smorales2405/Tesis_Mecanismo/LaTeX/Tesis_2025_1/images/1B.png

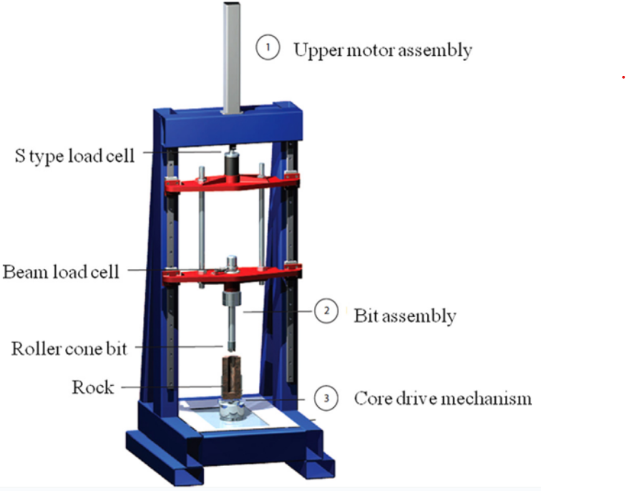
LaTeX/Tesis_2025_1/images/1B.png
