smorales2405/Tesis_Mecanismo/LaTeX/Tesis_2025_1/images/Esquematico_Tesis_bb2.png

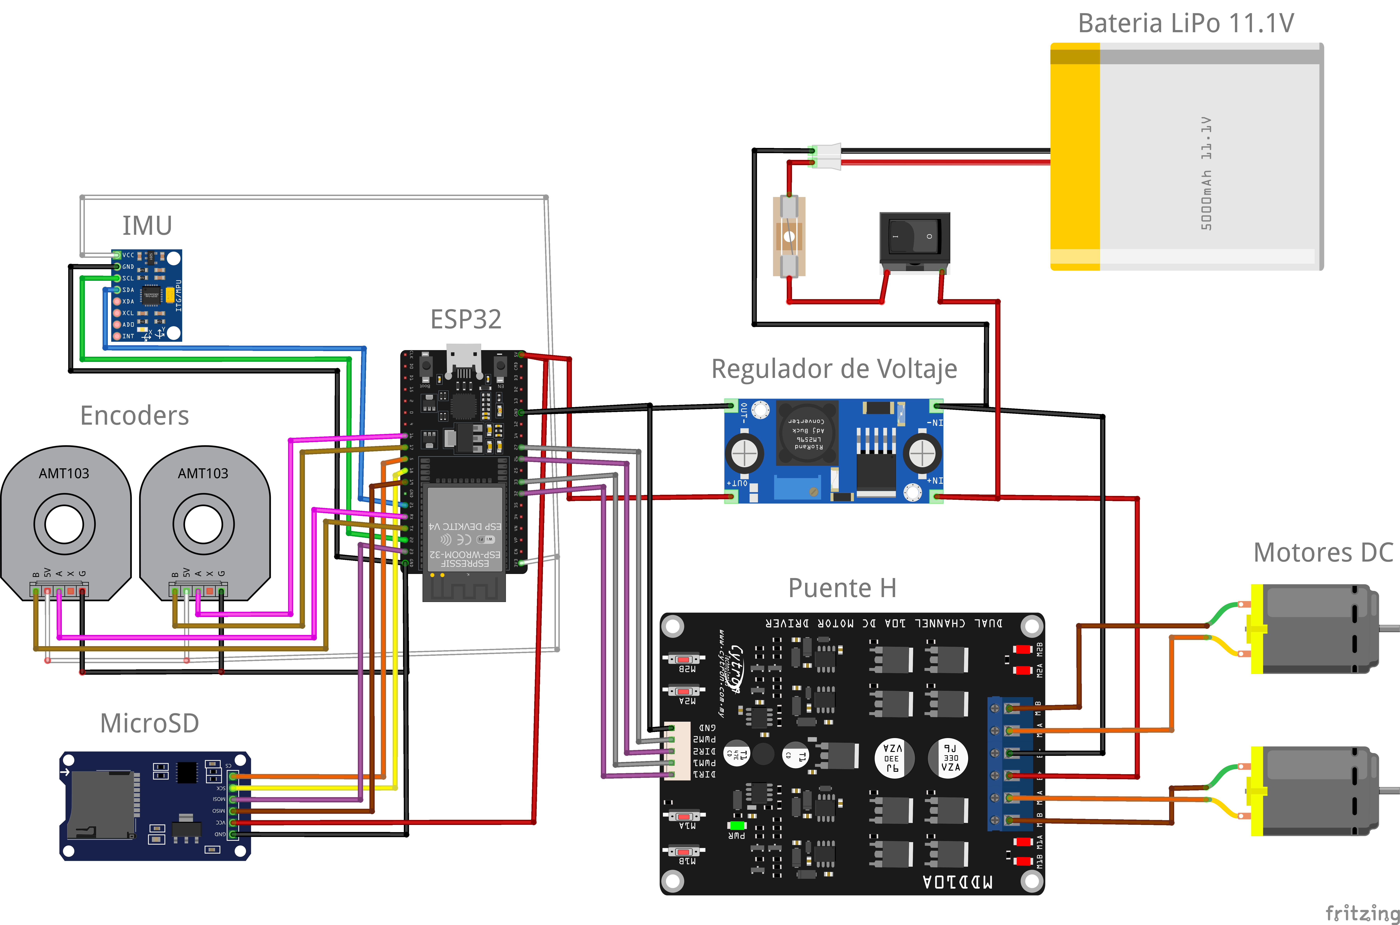
LaTeX/Tesis_2025_1/images/Esquematico_Tesis_bb2.png
