smorales2405/Tesis_Mecanismo/LaTeX/Tesis_2025_1/images/mecanismo_sevim.png

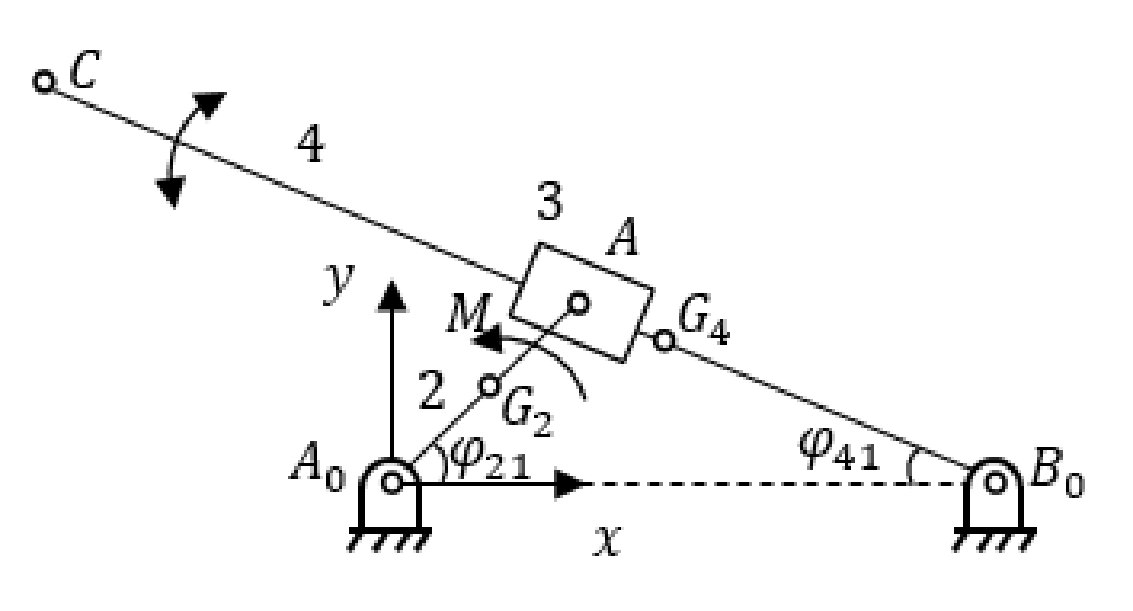
LaTeX/Tesis_2025_1/images/mecanismo_sevim.png
