smorales2405/Tesis_Mecanismo/LaTeX/Tesis_2025_1/images/simu.jpg

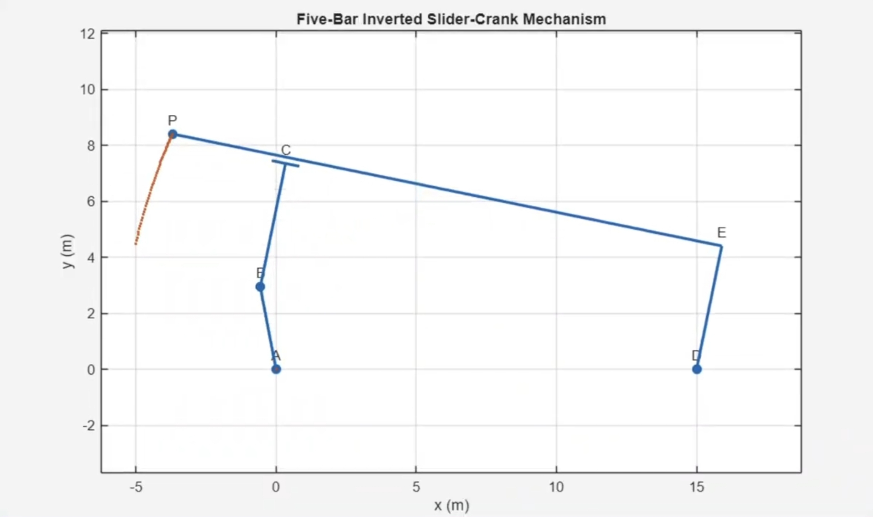
LaTeX/Tesis_2025_1/images/simu.jpg
