smorales2405/Tesis_Mecanismo/CAD/Piezas Variadas/Chumaceras/KFL08 - Mancal Flange oval Ø8.stp

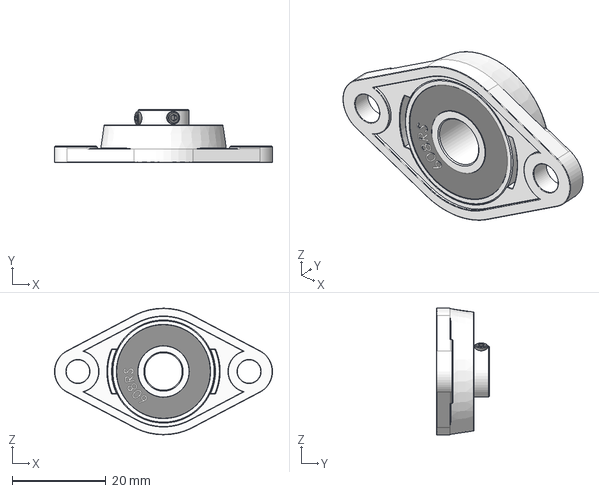
[picture p41: CAD file, 2025-10-18]
CAD/Piezas Variadas/Chumaceras/KFL08 - Mancal Flange oval Ø8.stp
46.5 x 11.4 x 27.0 mm
