smorales2405/Tesis_Mecanismo/CAD/Piezas Variadas/Motores/motor_bracket_base3.stl

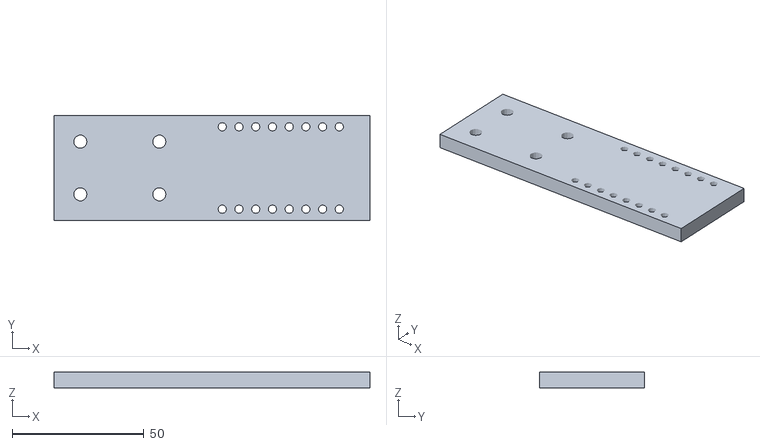
[picture p42: CAD file, 2025-11-20]
CAD/Piezas Variadas/Motores/motor_bracket_base3.stl
120.0 x 40.0 x 6.00
