smorales2405/Tesis_Mecanismo/CAD/Piezas Variadas/V_slots/2020 3-Bracket.stl

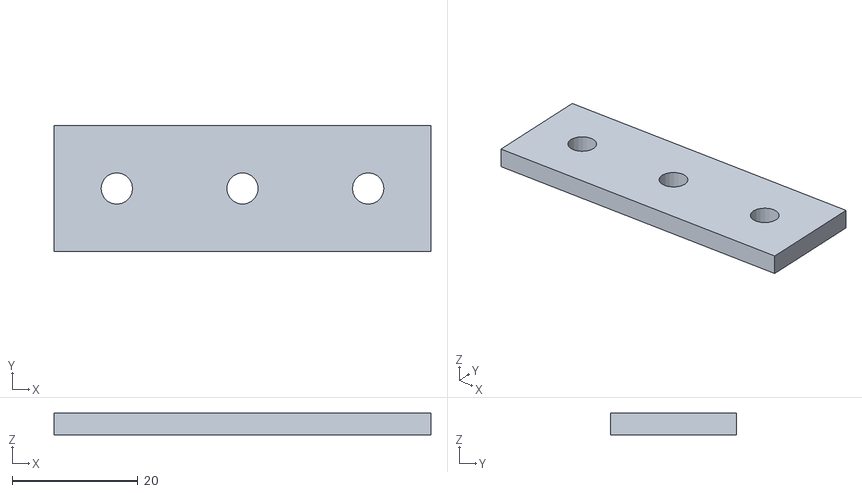
[picture p43: CAD file, 2025-11-19]
CAD/Piezas Variadas/V_slots/2020 3-Bracket.stl
60.0 x 20.0 x 3.50
