smorales2405/Tesis_Mecanismo/CAD/Piezas Variadas/V_slots/2020 gR Bracket.stl

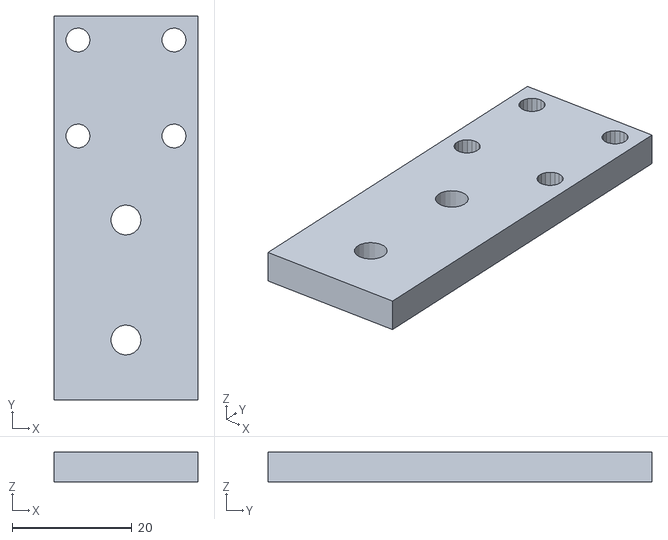
[picture p44: CAD file, 2025-11-17]
CAD/Piezas Variadas/V_slots/2020 gR Bracket.stl
24.0 x 64.0 x 5.00
