smorales2405/Tesis_Mecanismo/(list of files, cad)

Other CAD files:
CAD/Piezas Variadas/Motores/motor_bracket_base2.stl
CAD/Piezas Variadas/Motores/motor_bracket_base.stl
CAD/Base/Mecanismo_base_2.iam
CAD/Base/Mecanismo_base_al.ipt
CAD/Base/Mesa/Bord.iam
CAD/Base/Mesa/ben.ipt
CAD/Base/Mesa/ram.ipt
CAD/Base/Mesa/skiva.ipt
CAD/Linear Actuator/Linear Mechanism/1109-0024-0288.ipt
CAD/Linear Actuator/Linear Mechanism/1120-0011-0288.ipt
CAD/Linear Actuator/Linear Mechanism/1309-0016-4008.iam
CAD/Linear Actuator/Linear Mechanism/1310-0016-5008.iam
CAD/Linear Actuator/Linear Mechanism/1606-0043-0000.ipt
CAD/Linear Actuator/Linear Mechanism/1606-0043-0008.iam
CAD/Linear Actuator/Linear Mechanism/1611-0514-0008.iam
CAD/Linear Actuator/Linear Mechanism/1613-0516-0008 (1).iam
CAD/Linear Actuator/Linear Mechanism/1613-0516-0008 ball.ipt
CAD/Linear Actuator/Linear Mechanism/1613-0516-0008 carriage 15.5mm OD (1).iam
CAD/Linear Actuator/Linear Mechanism/1613-0516-0008 carriage 15.5mm OD.iam
CAD/Linear Actuator/Linear Mechanism/1613-0516-0008 washer (8.0mm ID x 15.5mm OD).ipt
CAD/Linear Actuator/Linear Mechanism/1613-0516-0008 washer (8.3mm ID x 15.5mm OD).ipt
CAD/Linear Actuator/Linear Mechanism/1613-0516-0008.iam
CAD/Linear Actuator/Linear Mechanism/2302-0014-0060.ipt
CAD/Linear Actuator/Linear Mechanism/2800-0004-0007.ipt
CAD/Linear Actuator/Linear Mechanism/2800-0004-0011.ipt
CAD/Linear Actuator/Linear Mechanism/2800-0004-0012.ipt
CAD/Linear Actuator/Linear Mechanism/2800-0004-0014.ipt
CAD/Linear Actuator/Linear Mechanism/3501-0804-0300.ipt
CAD/Linear Actuator/Linear Mechanism/3504-0804-2109.iam
CAD/Linear Actuator/Linear Mechanism/3505-0804-3216.ipt
CAD/Linear Actuator/Linear Mechanism/3704-0043-0002 w.Hardware (1).iam
CAD/Linear Actuator/Linear Mechanism/3704-0043-0002 w.Hardware.iam
CAD/Linear Actuator/Linear Mechanism/HARDWARE.iam
CAD/Linear Actuator/Linear Mechanism/IR.ipt
CAD/Linear Actuator/Linear Mechanism/Lead Screws/3501-0804-0150.ipt
CAD/Linear Actuator/Linear Mechanism/Lead Screws/3501-0804-0250.ipt
CAD/Linear Actuator/Linear Mechanism/OR.ipt
CAD/Linear Actuator/Linear Mechanism/OldVersions/HARDWARE.0001.iam
CAD/Linear Actuator/Linear Mechanism/Part32.ipt
CAD/Linear Actuator/Linear Mechanism/Part34.ipt
CAD/Linear Actuator/Linear Mechanism/Part46.ipt
CAD/Linear Actuator/Linear Mechanism/Part52.ipt
CAD/Linear Actuator/Linear Mechanism/Part56.ipt
CAD/Linear Actuator/Linear Mechanism/Rails/1109-0024-0060.ipt
CAD/Linear Actuator/Linear Mechanism/Rails/1109-0024-0120.ipt
CAD/Linear Actuator/Linear Mechanism/Rails/1109-0024-0168.ipt
CAD/Linear Actuator/Linear Mechanism/Rails/1109-0024-0240.ipt
CAD/Linear Actuator/Linear Mechanism/Rails/1204-0001-0001.ipt
CAD/Linear Actuator/Linear Mechanism/Rails/1204-0001-0002.ipt
CAD/Linear Actuator/Linear Mechanism/Rails/1204-0001-0003.ipt
CAD/Linear Actuator/Linear Mechanism/Rails/OldVersions/1109-0024-0060.0001.ipt
CAD/Linear Actuator/Linear Mechanism/U_Channels/1120-0004-0120.ipt
CAD/Linear Actuator/Linear Mechanism/U_Channels/1120-0006-0168.ipt
CAD/Linear Actuator/Linear Mechanism/U_Channels/1120-0007-0192.ipt
CAD/Linear Actuator/Linear Mechanism/U_Channels/1120-0008-0216.ipt
CAD/Linear Actuator/Linear Mechanism/U_Channels/1120-0009-0240.ipt
CAD/Linear Actuator/Linear Motor/5000-0001-0001 encoder cap screw_90190A075.ipt
CAD/Linear Actuator/Linear Motor/5000-0001-0001 encoder cap.ipt
CAD/Linear Actuator/Linear Motor/5000-0001-0001 encoder pin housing.ipt
CAD/Linear Actuator/Linear Motor/5000-0001-0001 encoder pins_MalePinHeader_1X2.ipt
CAD/Linear Actuator/Linear Motor/5000-0001-0001 motor shield.ipt
CAD/Linear Actuator/Linear Motor/5000-0002-0001 body.ipt
CAD/Linear Actuator/Linear Motor/5000-0002-0117 motor shaft.ipt
CAD/Linear Actuator/Linear Motor/5103 Gearbox Barrel (1 stage, simple)_Gear Blank.ipt
CAD/Linear Actuator/Linear Motor/5103 Gearbox Barrel Screw (M3 x 8mm length Flat Head)_92010A118.ipt
CAD/Linear Actuator/Linear Motor/5103 Gearbox Base Mounting Screw M3 x 5mm length SHCS)_91290A110.ipt
CAD/Linear Actuator/Linear Motor/5103 Gearbox Base.ipt
CAD/Linear Actuator/Linear Motor/5103 Gearbox Bearing.ipt
CAD/Linear Actuator/Linear Motor/5103 Gearbox Face.ipt
CAD/Linear Actuator/Linear Motor/5103 Gearbox Shaft (23.5mm Length, Simple).ipt
CAD/Linear Actuator/Linear Motor/5103 Gearbox Snap Ring.ipt
CAD/Linear Actuator/Linear Motor/5103-2402-0005 Simple.iam
CAD/Linear Actuator/Linear Motor/Linear_Motor.iam
CAD/Mecanismo_base.iam
CAD/OldVersions/Acople_rodamiento_lineal.0005.ipt
CAD/OldVersions/Mecanismo_base.0004.iam
CAD/OldVersions/Mecanismo_base_2.0018.iam
CAD/OldVersions/Mecanismo_base_al.0001.ipt
CAD/OldVersions/SC8UU.0001.ipt
CAD/OldVersions/eje8x100mm.0001.ipt
CAD/OldVersions/eje8x110mm.0001.ipt
CAD/OldVersions/eje8x120mm.0001.ipt
CAD/OldVersions/eje8x120mm.0001_1.ipt
CAD/OldVersions/eje8x120mm.0002.ipt
CAD/OldVersions/eje8x150mm.0002.ipt
CAD/OldVersions/eje8x160mm.0001.ipt
CAD/OldVersions/eje8x190mm.0001.ipt
CAD/OldVersions/eje8x200mm.0003.ipt
CAD/OldVersions/eje8x300mm.0003.ipt
CAD/OldVersions/eje8x30mm.0002.ipt
CAD/OldVersions/eje8x30mm.0004.ipt
CAD/OldVersions/eje8x40mm.0001.ipt
CAD/OldVersions/eje8x50mm.0001.ipt
CAD/OldVersions/eje8x60mm.0001.ipt
CAD/OldVersions/eje8x70mm.0002.ipt
CAD/OldVersions/eje8x80mm.0001.ipt
CAD/OldVersions/eje8x90mm.0001.ipt
CAD/OldVersions/vslot_25mm.0001.ipt
CAD/OldVersions/vslot_35mm.0001.ipt
CAD/OldVersions/vslot_400mm.0002.ipt
CAD/OldVersions/vslot_45mm.0002.ipt
CAD/OldVersions/vslot_580mm.0003.ipt
CAD/OldVersions/vslot_60mm.0003.ipt
CAD/OldVersions/vslot_700mm.0004.ipt
CAD/OldVersions/vslot_82mm.0003.ipt
CAD/Piezas Variadas/Acople_rodamiento_lineal.ipt
CAD/Piezas Variadas/Chumaceras/KFL08 - Mancal Flange oval Ø8.ipt
CAD/Piezas Variadas/Chumaceras/KFL08 - Mancal Flange oval Ø8_MIR.ipt
CAD/Piezas Variadas/Chumaceras/KFL08 - Mancal Flange oval Ø8_MIR1.ipt
CAD/Piezas Variadas/Chumaceras/KP08.ipt
CAD/Piezas Variadas/Chumaceras/OldVersions/KFL08 - Mancal Flange oval Ø8.0006.ipt
CAD/Piezas Variadas/Ejes/Acoples/30 Teeth GT2 Pulley 8mm.ipt
CAD/Piezas Variadas/Ejes/Acoples/GT2 60T id 8mm bw 7mm.ipt
CAD/Piezas Variadas/Ejes/Acoples/GT2 Timing Pulley, Configurable, 20T W6 B8.ipt
CAD/Piezas Variadas/Ejes/Acoples/GT2_20T-sh8.ipt
CAD/Piezas Variadas/Ejes/Acoples/Spider Shaft Coupler.ipt
CAD/Piezas Variadas/Ejes/OldVersions/eje8x200mm.0004.ipt
CAD/Piezas Variadas/Ejes/OldVersions/eje8x20mm.0001.ipt
CAD/Piezas Variadas/Ejes/OldVersions/eje8x250mm.0001.ipt
CAD/Piezas Variadas/Ejes/OldVersions/eje8x35mm.0001.ipt
CAD/Piezas Variadas/Ejes/OldVersions/eje8x70mm.0003.ipt
CAD/Piezas Variadas/Ejes/eje8x110mm.ipt
CAD/Piezas Variadas/Ejes/eje8x120mm.ipt
CAD/Piezas Variadas/Ejes/eje8x200mm.ipt
CAD/Piezas Variadas/Ejes/eje8x225mm.ipt
CAD/Piezas Variadas/Ejes/eje8x250mm.ipt
CAD/Piezas Variadas/Ejes/eje8x35mm.ipt
CAD/Piezas Variadas/Ejes/eje8x50mm.ipt
CAD/Piezas Variadas/Ejes/eje8x60mm.ipt
CAD/Piezas Variadas/Ejes/eje8x70mm.ipt
CAD/Piezas Variadas/Motores/0_12.ipt
CAD/Piezas Variadas/Motores/37d-gearmotor-100-131-encoder.ipt
CAD/Piezas Variadas/Motores/OldVersions/crank_motor_mount.0007.iam
CAD/Piezas Variadas/Motores/OldVersions/motor_bracket_base.0005.ipt
CAD/Piezas Variadas/Motores/OldVersions/motor_bracket_base2.0001.ipt
CAD/Piezas Variadas/Motores/OldVersions/motor_bracket_base3.0002.ipt
CAD/Piezas Variadas/Motores/OldVersions/pololu-stamped-aluminum-l-bracket-for-37d-mm-metal-gearmotors.0001.ipt
CAD/Piezas Variadas/Motores/Rot_Motor.ipt
CAD/Piezas Variadas/Motores/crank_motor_mount.iam
CAD/Piezas Variadas/Motores/motor_bracket_base.ipt
CAD/Piezas Variadas/Motores/motor_bracket_base2.ipt
CAD/Piezas Variadas/Motores/motor_bracket_base3.ipt
CAD/Piezas Variadas/Motores/pololu-stamped-aluminum-l-bracket-for-37d-mm-metal-gearmotors.ipt
CAD/Piezas Variadas/OldVersions/crank_motor_mount.0003.iam
CAD/Piezas Variadas/OldVersions/motor_bracket_base.0001.ipt
CAD/Piezas Variadas/Piñones y cadenas/1309-0016-0008/1309-0016-0008.iam
CAD/Piezas Variadas/Piñones y cadenas/1309-0016-0008/1309-0016-0008.ipt
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
