smorales2405/Tesis_Mecanismo/LaTeX/Tesis_2025_1/images/sim_vel_o-eps-converted-to.pdf

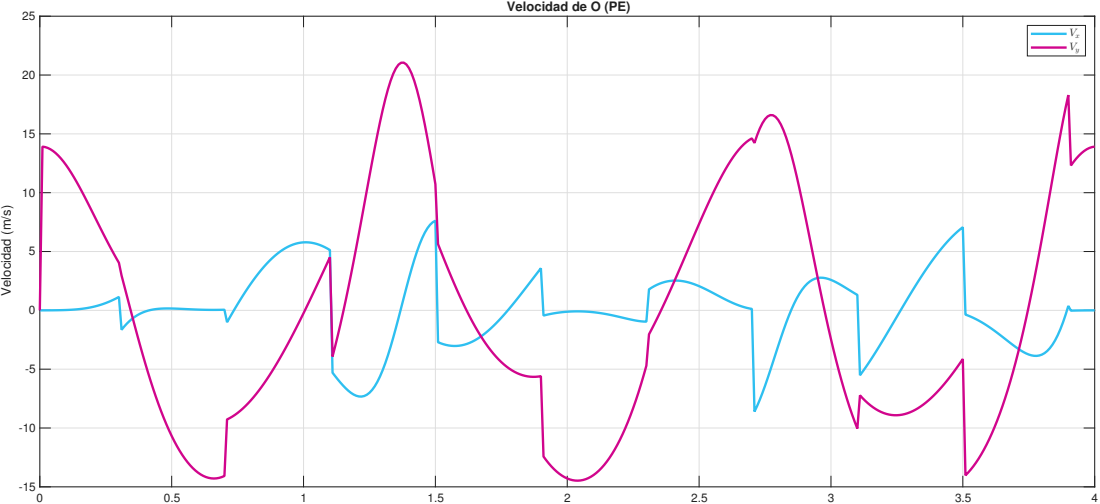
[picture p45: page 1]
Velocidad (m/s)

Velocidad de O (PE)
