smorales2405/Tesis_Mecanismo/LaTeX/Tesis_2025_1/images/sim_mechanism-eps-converted-to.pdf

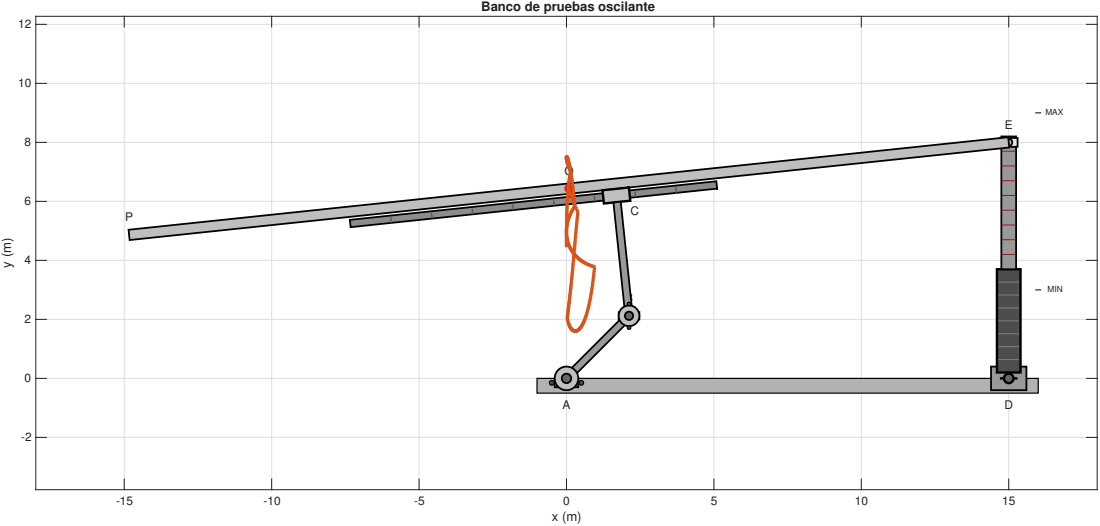
[picture p46: page 1]

Banco de pruebas oscilante

E | MAX

B | | MIN
