smorales2405/Tesis_Mecanismo/LaTeX/Tesis_2025_1/images/sim_pos_o-eps-converted-to.pdf

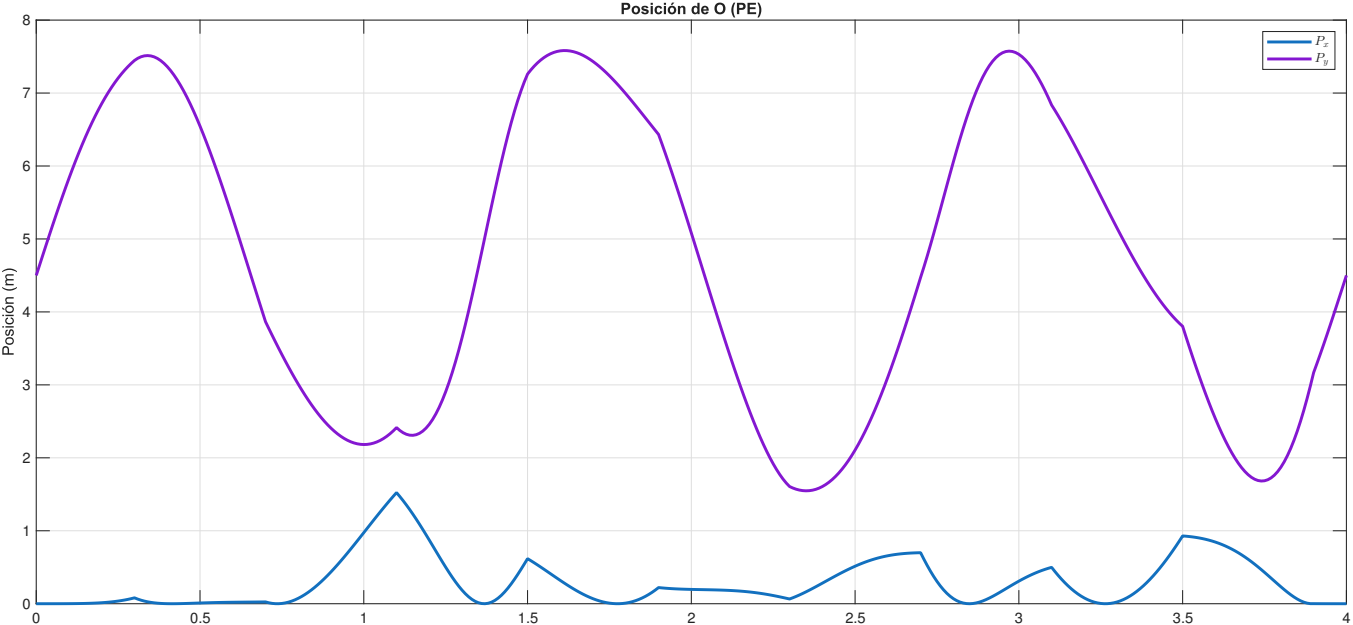
[picture p47: page 1]
