smorales2405/Tesis_Mecanismo/LaTeX/Tesis_2025_1/images/sim_theta4-eps-converted-to.pdf

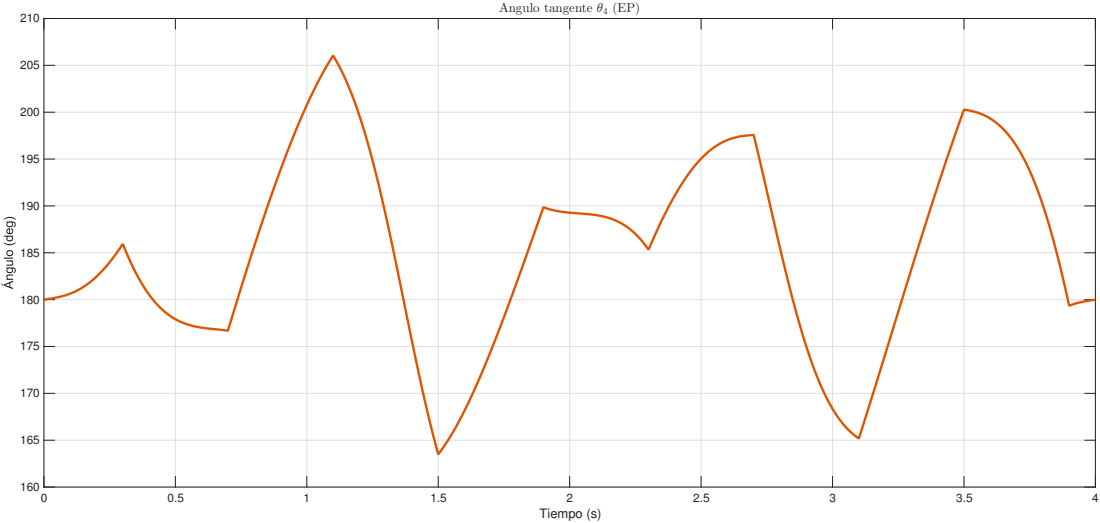
[picture p48: page 1]
Tiempo (s)

Angulo tangente θ4 (EP)
