smorales2405/Tesis_Mecanismo/(list of files, drawings)

Other design files:
Esquematico/Esquematico_Tesis.fzz
