smorales2405/Tesis_Mecanismo/(commit log)

2025-10-16 Change Visual, slider and rail
2025-10-16 Fuse and Switch
    [Esquematico_Tesis.fzz]
2025-10-23 Calculo de th3 y th4 sin optimizacion
2025-10-24 ESP32 IMU files
2025-10-28 Control PID 1
2025-11-08 Linear Actuator 2
    [1109-0024-0120.ipt, 1109-0024-0168.ipt, 1109-0024-0240.ipt, 1120-0004-0120.ipt, 1120-0006-0168.ipt, 1120-0007-0192.ipt, 1120-0008-0216.ipt, 1120-0009-0240.ipt]
2025-11-11 Mecanismo modificado
    [1109-0024-0060.ipt, 30 Teeth GT2 Pulley 8mm.ipt, 37d-gearmotor-100-131-encoder.ipt, GT2 60T id 8mm bw 7mm.ipt, GT2 Timing Pulley, Configurable, 20T W6 B8.ipt, Mecanismo_base_2.0011.iam, Mecanismo_base_2.iam, Rot_Motor.ipt]
2025-11-15 Mejora Mecanismo
    [0_12.ipt, 1204-0001-0001.ipt, 1204-0001-0002.ipt, 1204-0001-0003.ipt, 2020 Corner Bracket.ipt, 2020 corner joining plate.ipt, GT2_20T-sh8.ipt, Mecanismo_base_2.0011.iam]
2025-11-17 Eje separado y 2 chumaceras
    [1109-0024-0060.0001.ipt, 1109-0024-0060.ipt, 2020 gR Bracket.stl, 2020 goRail Bracket.ipt, eje8x70mm.0003.ipt, eje8x70mm.ipt, motor_bracket_base.0004.ipt, motor_bracket_base.0005.ipt]
2025-11-19 Mesa y soporte de Actuador
    [2020 3 Bracket.ipt, 2020 3-Bracket.stl, Bord.iam, Mecanismo_base_2.iam, Mecanismo_base_al.ipt, Plataforma_flotante.0016.iam, Plataforma_flotante.0020.iam, Plataforma_flotante.iam]
2025-11-20 Control Oscilatorio de Actuador Lineal
2025-11-20 Mecanismo con Faja
    [1309-0016-0008.iam, 1309-0016-0008.ipt, 2800-0004-0014_90128A207.ipt, 2806-0005-0004_91390A117.ipt, 3307-1006-0010 rev1_2302K82.ipt, 3307-1006-0010.iam, 3307-4008-0010 rev1_2302K82.ipt, 3307-4008-0010.iam]
2025-11-24 Enviar comandos a la vez y fijar limites al actuador
2025-11-24 Enviar PWM por Serial y leer Voltaje
2025-11-24 Inicializar Motor1
2025-11-24 Inicializar ambos motores
2025-11-25 Webserver Motores
2025-11-25 Uncomment Serial prints
2025-11-26 PID Sin Timer
2025-11-26 Para Arduino MEGA
2025-11-26 Motor1 y Motor2
2025-11-26 Control de M1 y M2 Arduino MEGA
2025-11-26 Data de PWM Velocidad
2025-11-26 Pines DIR y PWM
2025-11-26 Error, Derivada e Integral
    [ControlRoboclaw_Ident.ino]
